DanuRaj/Nvidia_carrier_board_buck_converter/README.md

# Nvidia_carrier_board_buck_converter

{3F92B3EE-17E5-41CC-94A1-E57578842CAD}

Nvidia_carrier_board_buck_converter: A redundant 16V, 10A power supply designed for drone applications. This system ensures continuous and reliable power to critical components, 
preventing a loss of control in case of a single power source failure.

## Board Function Description
- Controller Interface: This system is designed to provide a reliable and uninterrupted power supply by combining two independent buck converter outputs through
  ideal diode OR-ing controllers. The configuration ensures that if one power source fails, the other seamlessly takes over without significant voltage drop or back-feeding.
- Protection Features: Overcurrent and Short circuit, Thermal shutdown (168C), Output reverse current protections.
- Device Specification: Input voltage 6-36V, Output voltage 16V(10A max).

## Links
- Component Comparision, selection and budget calculation: https://1drv.ms/x/c/90db604890557ba4/EQwyB9T5Cy5Jqm9UW85tFZ8BQgGVj6BCc97MGfK7pBIuOw?e=8HD6iG
- Board version details: https://docs.google.com/spreadsheets/d/1ysmzugmfdfwkyfaRKPDwJ48EtTlpV0uTiGiZc5H5LqE/edit?usp=sharing
- Board fabrication batch details: https://docs.google.com/spreadsheets/d/1lbHuOr3Xf0H5Bty-ZQFxi4Lm0dUs_V9qaKUnfOi1CwQ/edit?usp=sharing
- Block diagram: https://drive.google.com/file/d/1fUM-bkZPR1wnyUHCijoqjtAjoX7Ru1Ks/view?usp=sharing
## Top and Bottom Images
<p align="left">
{FED3436D-6B1E-4319-BCD1-F0DEEA7FE846}

</p>
