DanuRaj/Nvidia_carrier_board_buck_converter/Reference design documents/Calculator Tool - LM62460-Q1, LM61480-Q1, LM61495-Q1.xlsx

 |  |  |  | LM62460-Q1, LM61480-Q1, LM61495-Q1 Buck Converter Design Tool
About |  |  | = Input Box
Step 1: Operating Specifications
Part Number | LM61495-Q1 |  |  |  |  |  |  |  |  |  | IOUT_MAX_TRIM | 10 | A | =10 if LM61495, 8 if LM61480, 6 if LM62440
VIN_MIN | 16 | V |  |  |  |  |  |  |  |  | IDEALDUTYCYCLE | 72.72727273% | % | =VOUT/VIN_NOM
VIN_NOM | 22 | V |  |  |  |  |  |  |  |  | PLOSS | 2.68 | W | =IOUT_MAX^2*(LDCR+IDEALDUTYCYCLE*RDSON_HS+IDEALDUTYCYCLE*RDSON_LS
VIN_MAX | 26 | V |  |  |  |  |  |  |  |  | POUT | 160 | W | =VOUT*IOUT_MAX
VOUT | 16 | V |  |  |  |  |  |  |  |  | PIN | 162.68 | W | =POUT+PLOSS
IOUT_MAX | 10 | A |  |  |  |  |  |  |  |  | EFFICIENCY | 98.35149483% | % | =POUT/PIN
FSW_SELECTED | 400 | kHz |  |  |  |  |  |  |  |  | DUTYCYCLE | 73.94628099% | % | =VOUT/(VIN*EFFICIENCY)
 |  |  |  |  |  |  |  |  |  |  | TON | 1.848657025e-06 | s | =(1/FSW_SELECTED)*DUTYCYCLE
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
