DanuRaj/Nvidia_carrier_board_buck_converter/Reference design documents/Block diagram.png

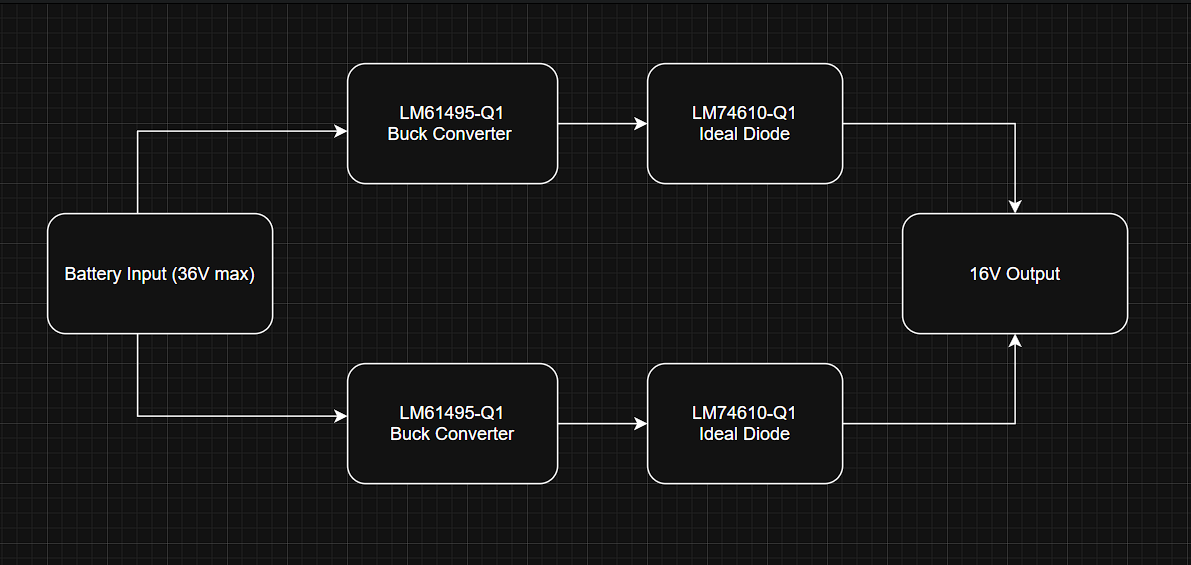
Reference design documents/Block diagram.png
