DanuRaj/Nvidia_carrier_board_buck_converter/Reference design documents/Design and component selection sheet.xlsx

Sheet: Component selection
Buck converter selection
 |  |  |  | Input voltage |  | Current |  | Unit price |  | Certifications | Digikey
LM61495 |  | Datasheet (https://www.ti.com/product/LM61495?keyMatch=LM61495&tisearch=universal_search&usecase=GPN) |  | 3-36V |  | 10A |  | $5.83
LM61495-Q1 |  | Datasheet (https://www.ti.com/product/LM61495-Q1) |  | 3-36V |  | 10A |  | $6.42 |  | ACE-Q100 | LM61495QRPHRQ1
Ideal diode selection
 |  |  |  | Input voltage |  | Current |  | Unit price |  | Certifications | Digikey | Features | Note
LM74610-Q1 |  | Datasheet (https://www.ti.com/lit/ds/symlink/lm74610-q1.pdf?ts=1757648061866) |  | 42V |  | MOSFET |  | $2.31 |  | AEC-Q100 | LM74610QDGKRQ1 |  | There are provided mosfets / application notes
LM74703-Q1 |  | Datasheet (https://www.ti.com/lit/ds/symlink/lm74703-q1.pdf?ts=1757657134207) |  | 65V |  | MOSFET |  | $1.89 |  | AEC-Q100 | LM74703QDDFRQ1 | FET power good and EN pin
MOSFET selection |  | N-channel
Important parameters
Id | Max continuous drain current |  |  |  | > Max load current
Vds | Max drain to source voltage
Is | Max source current through body diode |  |  |  | > Inrush current
Rdson | Drain to source on resistance
MPN |  |  | Mfr |  | Vdss |  | Max Rds On, Min Rds On |  | Rds On (Max) @ Id, Vgs |  | Vgs (Max) | Vgs(th) (Max) @ Id | Qualification | Unit Price
BSZ034N04LSATMA1 |  |  | infineon |  | 40 V |  | 4.5V, 10V |  | 3.4mOhm @ 20A, 10V |  | ±20V | 2V @ 250µA | AEC-Q101 | $1.06
CSD18501Q5A |  |  | TI |  | 40 V |  | 4.5V, 10V |  | 3.2mOhm @ 25A, 10V |  | ±20V | 2.3V @ 250µA |  | $2.81
SQJ412EP-T1_GE3 |  |  | Vishay |  | 40 V |  | 4.5V, 10V |  | 4.1mOhm @ 10.3A, 10V |  | ±20V | 2.5V @ 250µA | AEC-Q101 | $2.76

Sheet: Design
Input voltage |  |  |  |  |  |  | Pin configuration
 |  |  |  |  |  |  | RT | Freq set | Connected to VCC of IC for 400KHz
For li-ion 6 cellls |  |  |  |  |  |  | EN | Output enable | Connected to VIN |  | No input UVLO
4.2*6 | 25.2V |  |  |  |  |  | RESET | Open drain output | Active low |  | Pulled-up to Vout 16V |  |  | Abs max | 20V
3.7*6 | 22.2V |  |  |  |  |  | SPSP | Spread spectrum | Connected through a resistor to GND |  |  |  | Reduce the output voltage ripple caused by the Fre Modu
3*6 | 18V |  |  |  |  |  |  |  | R = 11.81K
2.8*6 | 16.8V
 |  |  |  |  |  |  | SYNC/MODE | Operating mode select |  | Connected to GND for PFM |  |  | Switches to PFM at light loads
 |  |  |  |  |  |  | BIAS | Input to internal Voltage regulator |  |  | Connected to GND |  |  | It takes power from VIN |  |  | Block diagram
Switching frequency |  |  |  |  |  |  | RBOOT | Used to adjust the SW node rise time |  |  | Connected to CBOOT through a 0ohm resistor |  |  |  |  | For maximum rise time
400KHz |  | Low switching losses |  |  |  |  | FB | Vout feed back |  | Vout = 16.04 |  | Rfbt =6.65K
 |  | Higher efficiency
 |  | Low power dissipate
Inductor selection
Inductance |  | 3.6uH
Ripple current |  | 2.9A |  | 30% of max load current
DC current |  | 10-12A
Saturation current |  | 13-15A
7447709003 |  | FIXED IND 3.5UH 11A 9 MOHM SMD |  |  | $2.57
ASPIAIG-F1265-4R7M-T |  | FIXED IND 4.7UH 13.5A 8.4MOHM SM |  |  | $2.41
Trace width calculations
For 1 OZ inner layers |  |  |  |  |  |  |  | For 2 OZ outer layers
Via current carring capacity |  | Calculator (https://designertools.app.protoexpress.com/?appid=VCCWCAL&q=Wed%20Sep%2017%2022:23:51%20PDT%202025)
IPC class 2 via plating thickness |  | 0.02mm / 0.78mils
Edge plating reference
Link (https://www.protoexpress.com/kb/side-plating/)
Top and bottom ground pour |  | pull out 20mils from board edge
Inner ground and power layers |  | pull in 25 mils from board edge
MOSFET power dissipation calculation |  |  | BSZ034N04LSATMA1
Mosfet conduction loss |  |  |  |  | Temperature rise
Rdson, max = 3.4m ohm
I max = 10A
Power loss = 0.34W
 |  |  |  |  |  | Ambient temperature = 30 °C
 |  |  |  |  |  | Junction temperature = 50.4 °C
Layer stack
