DanuRaj/Nvidia_carrier_board_buck_converter/Altium_project_DPRS10A16V/Fab Files/Fab File V1/Fabrication V1/BOM/Bill of Materials-DPRS10A16V-Final.xlsx

Bill Of Materials |  |  |  | Bill of Materials for [Bill of Materials-DPRS10A16V.BomDoc]
 |  |  | Source Data From: | Bill of Materials-DPRS10A16V.BomDoc
 |  |  | Project: | Altium_project_DPRS10A16V.PrjPCB
 |  |  | Variant: | No Variant
 |  | Report Date:(MM/DD/YY) | 2025-10-09
 |  | Print Date: (MM/DD/YY) | 2025-10-09
Line | Quantity | Designator | Description | Manufacturer 1 | Manufacturer Part Number 1
 | 4 | C1A, C1B, C7A, C7B | 47ÂµF 50V Aluminum Electrolytic Capacitors Radial, Can - SMD 680mOhm @ 100kHz 2000 Hrs @ 105Â°C |  | EEE-FT1H470AP
 | 4 | C2A, C2B, C3A, C3B | 10 µF ±10% 50V Ceramic Capacitor X7R 1206 (3216 Metric) |  | C3216X7R1H106K160AC
 | 4 | C4A, C4B, C5A, C5B | 0.47 µF ±10% 50V Ceramic Capacitor X7R 0603 (1608 Metric) |  | CGA3E3X7R1H474K080AB
 | 2 | C6A, C6B | 0603 1 uF 25 V ±10% Tolerance X7R SMT Multilayer Ceramic Capacitor |  | TMK107B7105KA-T
 | 8 | C8A, C8B, C9A, C9B, C10A, C10B, C11A, C11B | Multilayer Ceramic Capacitors MLCC – SMD/SMT; TDK; C3216X5R1V226M160AC; 22 µF; 1206; 35 V; 35 V |  | C3216X5R1V226M160AC
 | 4 | C12A, C12B, C13A, C13B | Cap Ceramic 2.2uF 35V X7R 10% Pad SMD 0805 Soft Termination 125C Automotive T/R |  | CGA4J1X7R1V225K125AE
 | 2 | C14A, C14B | CGA Series 0402 100 nF 50 V ±10 % Tolerance X7R SMT Multilayer Ceramic Capacitor |  | CGA2B3X7R1H104K050BB
 | 2 | C15A, C15B | Multilayer Ceramic Capacitors MLCC - SMD/SMT 50V 10pF X7R 0402 10% |  | C0402C100K5RACTU
 | 2 | C16, C23 | 50V 100pF X7R ±10% 0402 Multilayer Ceramic Capacitors MLCC - SMD/SMT ROHS |  | CC0402KRX7R9BB101
 | 2 | C17, C19 | Ceramic Capacitor, Multilayer, Ceramic, 50V, 10% +Tol, 10% -Tol, X7R, 15% TC, 4.7uF, Surface Mount, 0805 |  | CGA4J1X7R1H475K125AC
 | 2 | C18, C24 | 25V 2.2uF X7R ±10% 0603 Multilayer Ceramic Capacitors MLCC - SMD/SMT ROHS |  | GRM188Z71E225KE43D
 | 2 | C20, C21 | 50V 1uF X7R ±10% 0603 Multilayer Ceramic Capacitors MLCC - SMD/SMT ROHS |  | CC0603KRX7R9BB105
 | 3 | D1, D2, D3 | Green 569nm LED Indication - Discrete 2.1V 0603 (1608 Metric) |  | LTST-C190GKT
 | 4 | J1, J2, J3, J4 | Connector Header Surface Mount, Right Angle 4 position 0.079" (2.00mm) |  | SM04B-PASS-TBT
 | 2 | L1A, L1B | WE-PD SMT Power Inductor, size 1210, 3.5uH, 11A, 9mOhm |  | 3.5uH, 11A
 | 2 | PS1A, PS1B | 10-A automotive buck converter optimized for power density and low EMI |  | LM61495QRPHRQ1
 | 2 | Q1, Q2 | N-Channel 40 V 19A (Ta), 40A (Tc) 2.1W (Ta), 52W (Tc) Surface Mount PG-TSDSON-8-FL |  | BSZ034N04LSATMA1
 | 4 | R1A, R1B, R5A, R5B | 62.5mW Thick Film Resistors 50V ±100ppm/℃ ±5% 100kΩ 0402 Chip Resistor - Surface Mount ROHS |  | RC0402JR-07100KL
 | 2 | R2A, R2B | Res Thick Film 0402 11.8K Ohm 1% 0.063W(1/16W) 100ppm/C Pad SMD T/R |  | RC0402FR-1311K8L
 | 2 | R3A, R3B | Zero Ohm Resistor, Thick Film, 100 mW, 1 A, Surface Mount, 0402 [1005 Metric] |  | ERJ-2GE0R00X
 | 2 | R4A, R4B | Res Thick Film 0402 4.99K Ohm 1% 0.1W(1/10W) ±100ppm/C Pad SMD Automotive T/R |  | RK73H1ETTP4991F
 | 2 | R6A, R6B | Res Thick Film 0402 6.65K Ohm 1% 0.1W(1/10W) ±100ppm/C Pad SMD Automotive T/R |  | RK73H1ETTP6651F
 | 3 | R7, R8, R9 | Res Thick Film 0402 1.5K Ohm 1% 0.2W(1/5W) ±100ppm/C Pad SMD T/R Automotive AEC-Q200 |  | ERJ-PA2F1501X
 | 2 | U1, U2 | 0.48-V to 42-V, zero IQ automotive ideal diode controller |  | LM74610QDGKRQ1
 | 68
