DanuRaj/Nvidia_carrier_board_buck_converter/Altium_project_DPRS10A16V/Downloaded component libs/C3216X7R1H106K160AC (1)/AltiumDesigner/CAP_3216_TDK.step

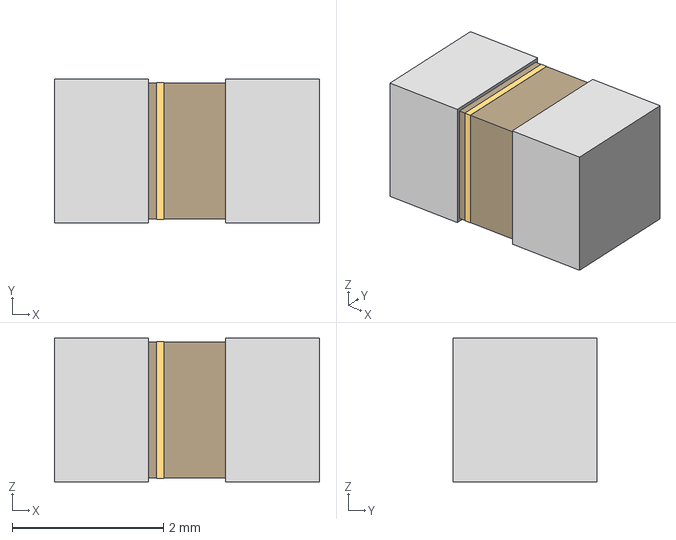
[picture p2: CAD file, 2025-09-15]
Altium_project_DPRS10A16V/Downloaded component libs/C3216X7R1H106K160AC (1)/AltiumDesigner/CAP_3216_TDK.step
3.51 x 1.90 x 1.91 mm
