DanuRaj/Nvidia_carrier_board_buck_converter/Altium_project_DPRS10A16V/Downloaded component libs/CGA3E3X7R1H474K080AB/AltiumDesigner/CAP_1608_TDK.step

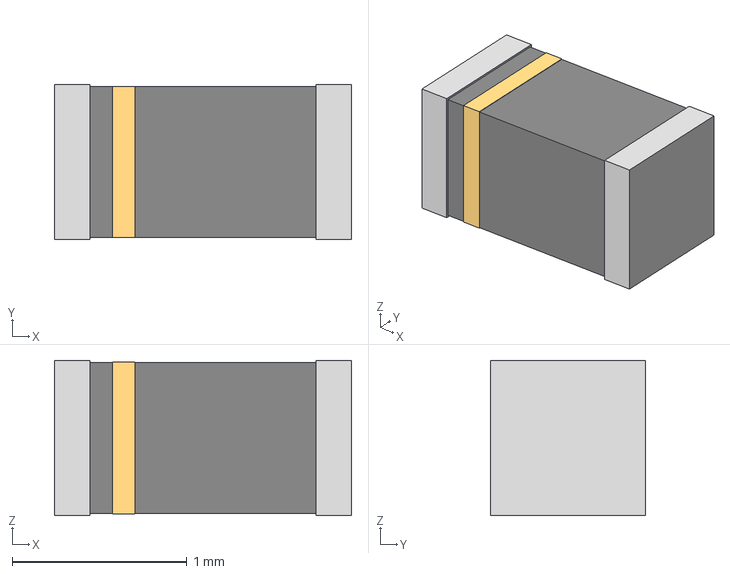
[picture p3: CAD file, 2025-09-15]
Altium_project_DPRS10A16V/Downloaded component libs/CGA3E3X7R1H474K080AB/AltiumDesigner/CAP_1608_TDK.step
1.70 x 0.888 x 0.889 mm
