DanuRaj/Nvidia_carrier_board_buck_converter/Altium_project_DPRS10A16V/Downloaded component libs/ERJ_2GEJ473X/AltiumDesigner/RC0402N_PAN.step

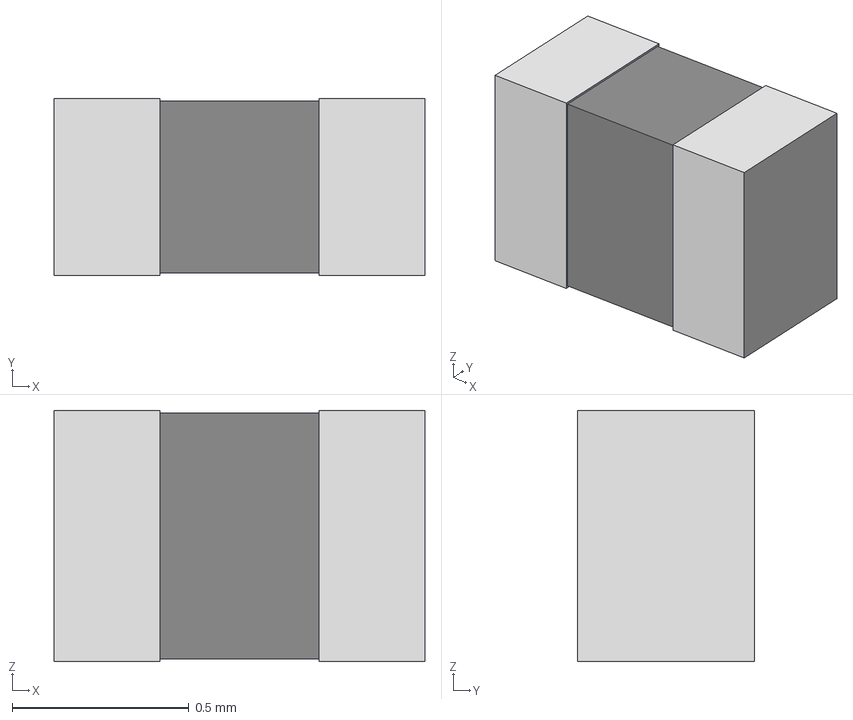
[picture p4: CAD file, 2025-09-15]
Altium_project_DPRS10A16V/Downloaded component libs/ERJ_2GEJ473X/AltiumDesigner/RC0402N_PAN.step
1.05 x 0.5 x 0.711 mm
