DanuRaj/Nvidia_carrier_board_buck_converter/Altium_project_DPRS10A16V/Downloaded component libs/ul_PLM61495QRPHRQ1/RPH0016A.stp

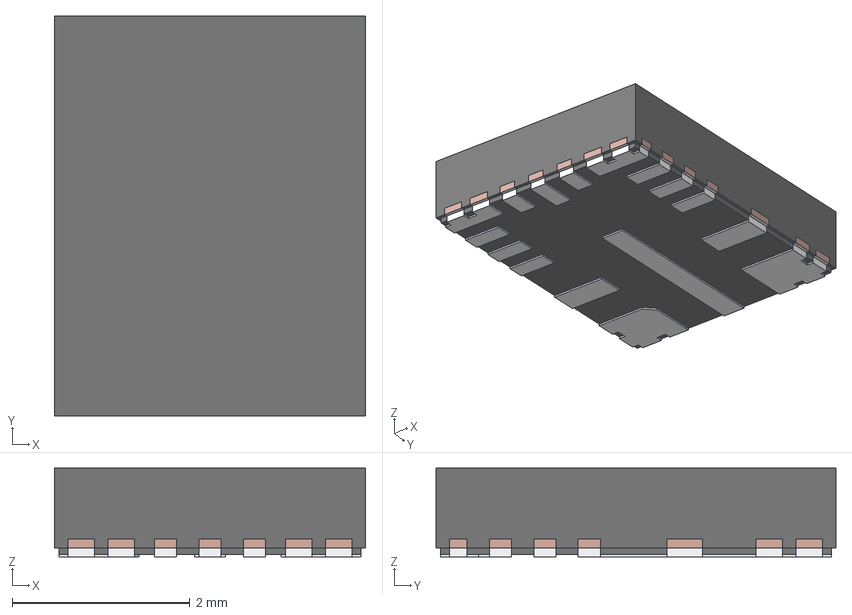
[picture p5: CAD file, 2025-09-15]
Altium_project_DPRS10A16V/Downloaded component libs/ul_PLM61495QRPHRQ1/RPH0016A.stp
3.50 x 4.50 x 1.00 mm
FRAME_AF0
BODY_AF0
PIN1_AREA
