DanuRaj/Nvidia_carrier_board_buck_converter/(list of files, cad)

Other CAD files:
Altium_project_DPRS10A16V/Downloaded component libs/C3216X7R1H106K160AC (1)/CAP_3216_TDK.step
Altium_project_DPRS10A16V/Downloaded component libs/CGA3E3X7R1H474K080AB/CAP_1608_TDK.step
Altium_project_DPRS10A16V/Downloaded component libs/ERJ_2GEJ473X/RC0402N_PAN.step
