DanuRaj/Nvidia_carrier_board_buck_converter/(list of files, drawings)

Other design files:
Altium_project_DPRS10A16V/Altium_project_DPRS10A16V.PrjPcb
Altium_project_DPRS10A16V/Buck.SchDoc
Altium_project_DPRS10A16V/Downloaded component libs/C3216X7R1H106K160AC (1)/AltiumDesigner/C3216X7R1H106K160AC.PcbLib
Altium_project_DPRS10A16V/Downloaded component libs/C3216X7R1H106K160AC (1)/AltiumDesigner/C3216X7R1H106K160AC.SchLib
Altium_project_DPRS10A16V/Downloaded component libs/CGA3E3X7R1H474K080AB/AltiumDesigner/CGA3E3X7R1H474K080AB.PcbLib
Altium_project_DPRS10A16V/Downloaded component libs/CGA3E3X7R1H474K080AB/AltiumDesigner/CGA3E3X7R1H474K080AB.SchLib
Altium_project_DPRS10A16V/Downloaded component libs/EEE_FT1H470AP/EEEFT1H470AP/CAP_EEEFT1H470AP.PcbLib
Altium_project_DPRS10A16V/Downloaded component libs/EEE_FT1H470AP/EEEFT1H470AP/EEEFT1H470AP.SchLib
Altium_project_DPRS10A16V/Downloaded component libs/ERJ_2GEJ473X/AltiumDesigner/ERJ-2GEJ473X.PcbLib
Altium_project_DPRS10A16V/Downloaded component libs/ERJ_2GEJ473X/AltiumDesigner/ERJ-2GEJ473X.SchLib
Altium_project_DPRS10A16V/Downloaded component libs/infineon-pcb-footprints-and-symbols/BSZ034N04LS.SchLib
Altium_project_DPRS10A16V/Downloaded component libs/infineon-pcb-footprints-and-symbols/INF-PG-TSDSON-8-FL.PcbLib
Altium_project_DPRS10A16V/Downloaded component libs/LM74610QDGKRQ1/LM74610QDGKRQ1/LM74610QDGKRQ1.SchLib
Altium_project_DPRS10A16V/Downloaded component libs/LM74610QDGKRQ1/LM74610QDGKRQ1/SOP65P490X110-8N.PcbLib
Altium_project_DPRS10A16V/Downloaded component libs/ul_PLM61495QRPHRQ1/AltiumDesigner/PLM61495QRPHRQ1.PcbLib
Altium_project_DPRS10A16V/Downloaded component libs/ul_PLM61495QRPHRQ1/AltiumDesigner/PLM61495QRPHRQ1.SchLib
Altium_project_DPRS10A16V/Downloaded component libs/ul_PLM61495QRPHRQ1/AltiumDesigner/Schlib1.SchLib
Altium_project_DPRS10A16V/DPRS10A16V.PcbDoc
Altium_project_DPRS10A16V/IdealDiodeMain.SchDoc
Altium_project_DPRS10A16V/PcbLib1.PcbLib
