DanuRaj/Nvidia_carrier_board_buck_converter/(commit log)

2025-09-15 1. initial commit
    [Altium_project_DPRS10A16V.PrjPcb, BSZ034N04LS.SchLib, Buck.SchDoc, C3216X7R1H106K160AC.PcbLib, C3216X7R1H106K160AC.SchLib, CAP_1608_TDK.step, CAP_3216_TDK.step, CAP_EEEFT1H470AP.PcbLib]
2025-09-15 2. completed the schematic
    annotated and updated the pcb, creat rooms
    [Altium_project_DPRS10A16V.PrjPcb, Buck.SchDoc, DPRS10A16V.PcbDoc, IdealDiodeMain.SchDoc, PcbLib1.PcbLib, Schlib1.SchLib]
2025-09-16 3. placed components
    updated design rules and board shape
    [Buck.SchDoc, DPRS10A16V.PcbDoc, Design and component selection sheet.xlsx, IdealDiodeMain.SchDoc, PcbLib1.PcbLib]
2025-09-17 4. updated power polygons
    [DPRS10A16V.PcbDoc, Design and component selection sheet.xlsx, PcbLib1.PcbLib]
2025-09-18 5. placed vias
    [DPRS10A16V.PcbDoc, Design and component selection sheet.xlsx]
2025-09-18 6. checked design rules and added edge plating
    [Altium_project_DPRS10A16V.PrjPcb, DPRS10A16V.PcbDoc, PcbLib1.PcbLib]
2025-09-19 7. update silkscreen and plane clearance
    [Altium_project_DPRS10A16V.PrjPcb, DPRS10A16V.PcbDoc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]
2025-10-07 updated fab files
    [Bill of Materials-DPRS10A16V.xlsx, DPRS10A16V.PcbDoc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]
2025-10-10 BoM updated
    [Bill of Materials-DPRS10A16V-Final.xlsx]
2025-10-28 copied fab files to fab output folder
    [Bill of Materials-DPRS10A16V-Final.xlsx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]
